ocarizr/tgUnip/docs/validacao-bancada.md

# Protocolo de bancada da revisão dinâmica

Status: **pendente; nenhum ensaio físico novo foi executado**. Este documento pode ser executado pelo responsável de laboratório após revisar pinagem, alimentação, montagem e calibração. A compilação não é autorização para gravar firmware.

## Preparação e referências

Registrar sensor, módulo, Mega, shield, versão do código, core, hashes das bibliotecas e identificação da calibração. Fotografar e desenhar eixos de S e B; testar seis faces e três rotações positivas. Identidade S=B precisa de confirmação. Medir alimentação e níveis/pull-ups de SDA/SCL adequados ao módulo; verificar se o shield expõe SDA20/SCL21 sem conflitos. O pino INT do MPU fica desconectado; o pino 2 é do toque. Rodar a calibração URTouch da biblioteca e confirmar cantos e regiões antes de confiar nos botões.

Usar referência angular calibrada com rastreabilidade e incerteza declarada, preferencialmente encoder e mesa ou sistema óptico tridimensional para movimento composto. Meta inicial: incerteza expandida da referência ≤0,2°, **a confirmar**, com resolução ≤0,05°. Esquadros sem certificado e sem controle do assentamento não satisfazem automaticamente essa meta. Registrar desalinhamento entre referência e corpo e estabilidade da fixação. Identificar braço de alavanca r entre centro de rotação e sensor.

Sincronizar referência e telemetria por evento observável comum, por exemplo degrau de movimento com ambos os registros; estimar atraso por correlação e registrar incerteza temporal. Para medir atraso absoluto usar analisador lógico em SDA/SCL e UART e referência sincronizada. Não adicionar fio de sincronismo ao Mega sem auditar conflitos com o shield. O timestamp registrado é fim do burst I²C; não confundi-lo com tempo de conversão do MPU.

## Sequência executável

1. Aquecer por 10 minutos como condição **provisória**, registrando temperatura bruta e convertida. Repetir estudo desde a energização para decidir tempo de aquecimento real. Capturar binário sem comandos; gerar CSV com `python scripts/telemetry.py recording.bin output.csv`. A abertura da serial pode reiniciar o Mega por DTR; guardar o trecho de partida.
2. Em cada face +X, −X, +Y, −Y, +Z, −Z do **sensor**, registrar 60 s em repouso; descartar assentamento inicial explicitamente, sem selecionar amostras por erro da saída. Repetir montagem cinco vezes por face. Todos os canais devem ser preservados. Rejeitar saturação, lacunas de sequência, variância e alinhamento incompatíveis. Registrar gravidade local adotada e sua fonte/incerteza.
3. Executar `python scripts/calibrate.py xp.csv xn.csv yp.csv yn.csv zp.csv zn.csv --g-local 1.0 --output .build/CalibrationData.h`, substituindo 1.0 pelo valor local justificado. Revisar JSON, médias e resíduos. Identidade de montagem gerada é hipótese. Só então integrar o header, compilar e gravar com autorização do operador. Estacionar e enviar `c`; aguardar pelo menos três segundos contínuos e confirmar estado FUSAO. Repetir cinco partidas em orientações distintas.
4. Avaliar inclinações estáticas independentes da calibração: 0°, ±15°, ±30°, ±45°, ±60°, 90°, 135° e 180°, em planos compatíveis com a montagem. Fazer cinco repetições com novo assentamento por ponto e coletar pelo menos 20 s após estabilização. Registrar Y indefinido nas orientações singulares, sem tratá-lo como erro numérico zero. Comparar direção vertical e sinais de X/Y, não somente magnitude.
5. Na mesa de um eixo, executar taxas positivas e negativas de 10, 30 e 90°/s, três revoluções completas, cinco repetições. Esses valores são propostas de ensaio, não faixa validada. Uma mesa de um eixo valida somente essa trajetória. Para alegar 3D, usar referência óptica/mesa apropriada e executar sequências não comutativas, taxas variáveis e movimento combinado com referência temporal.
6. Introduzir translação, oscilações e rotação com diferentes braços de alavanca. Incluir perturbação cuja norma de força específica fique próxima de 1 g com direção alterada. Medir duração do estado SO GIRO e erro durante e após a perturbação. O retorno ao estado FUSAO não prova ausência de aceleração. Não exigir que a fusão supere a referência estática em todo cenário.
7. Interromper I²C/desconectar sensor, provocar lacuna temporal e restabelecer conexão. Confirmar falha, rejeição de dado velho e necessidade de C para recuperação. Não fazer curto entre alimentação e dados. Confirmar tara, U e R em repouso, inclusive corte de ±180° e tentativa de tara em singularidade. Registrar estado LAB se override deliberadamente habilitado.
8. Repetir após cinco ciclos de alimentação e nas temperaturas seguras permitidas pelo hardware, registradas com instrumento independente. Não extrapolar uma calibração à temperatura inteira de operação. Registrar deriva em repouso por pelo menos uma hora para análise de estabilidade; estimar Allan para vários τ e informar número de blocos e regularidade temporal.

## Métricas, orçamento e critérios provisórios

Calcular erro de direção vertical arccos(u_ref·u_estimado), RMSE, MAE, máximo, viés por posição e repetibilidade entre montagens. Quando houver referência completa, calcular erro geodésico em SO(3), separando-o das alegações de inclinação. Medir tempo de acomodação e recuperação para uma faixa definida, atraso e jitter, taxa efetiva, leituras detectadas, perdas **estimadas** pelo polling, descartes UART e CRCs inválidos. Informar tamanho do registro, exclusões justificadas e intervalos de avaliação.

Metas iniciais para discussão: RMSE estático ≤1°; RMSE de direção vertical ≤2° em rotações controladas de banda baixa sem translação significativa; nenhuma saída válida após falha; nenhum descarte de telemetria em ensaio nominal de 10 minutos; intervalo entre leituras dentro de 5–30 ms; pelo menos 1 kB de margem mínima de pilha medida no pior cenário. Essas metas não foram demonstradas e podem ser revistas **antes** de avaliar os registros finais, com justificativa e histórico.

Registrar no analisador lógico o pior tempo de leitura, estimador, serial e cada chamada do LCD/toque. `max_render_us` cobre desenho, não cobre todo o toque nem todo o ciclo; usar captura externa para o total. Se o ciclo não sustentar 50 Hz, a configuração não passa: reduzir bloqueios, considerar FIFO com tratamento de overflow ou reprojetar a taxa/filtro e repetir os ensaios. Não anunciar taxa inferior como se fosse a original. O DLPF de 44/42 Hz não é anti-alias ideal para saída de 50 Hz: medir vibração fora de banda e avaliar filtro mais estreito com seu atraso.

Combinar incertezas de referência, montagem, sincronismo, temperatura e repetibilidade com hipóteses explícitas; não fabricar intervalos de confiança sem dados. Separar treinamento de parâmetros e avaliação final: conservar conjunto de ensaios não utilizado para escolher k_P, gates e compensações. Publicar registros brutos e script de análise com proveniência e permissão do laboratório.
