ocarizr/tgUnip/(commit log)

2018-11-22 remoção de arquivos
    Atualizados alguns arquivos e removidos outros julgados desnecessários.
2018-12-12 update
    a complete rewrite of the monografia file and the PowerPoint presentation
2026-10-22 Update dos documentos e atualizado para formato melhor visualizavel no Github (#1)
2026-10-22 refactor: modulariza o firmware DynamicIMU (#2)
    Separa aquisição, processamento, telemetria, hardware e interface.
    Simplifica o entry point, adiciona testes de integração e atualiza a documentação.
2026-10-22 adiciona badges de CI, plataforma e monografia ao README (#4)
